fl4p/bms-c1/kicad/Parts.md

Power Switches

Cheaper: XPQR8308QB,LXHQ
NVBLS0D8N08XTXG

TODO
* do extensive search based on Rds_on/px100
* look for high Vpl switches (with eFuse)
* look for high Qgd/Qgs switches

# Todo
* build in crow-bar?
* replace power supply with lm5163
* use waveshare break-out?
* relais output
* GPIO 1A-3A switch outputs
