fl4p/bms-c1/kicad/bms-c1.kicad_pcb

## KiCad design kicad/bms-c1.kicad_pcb (2024-11-30)

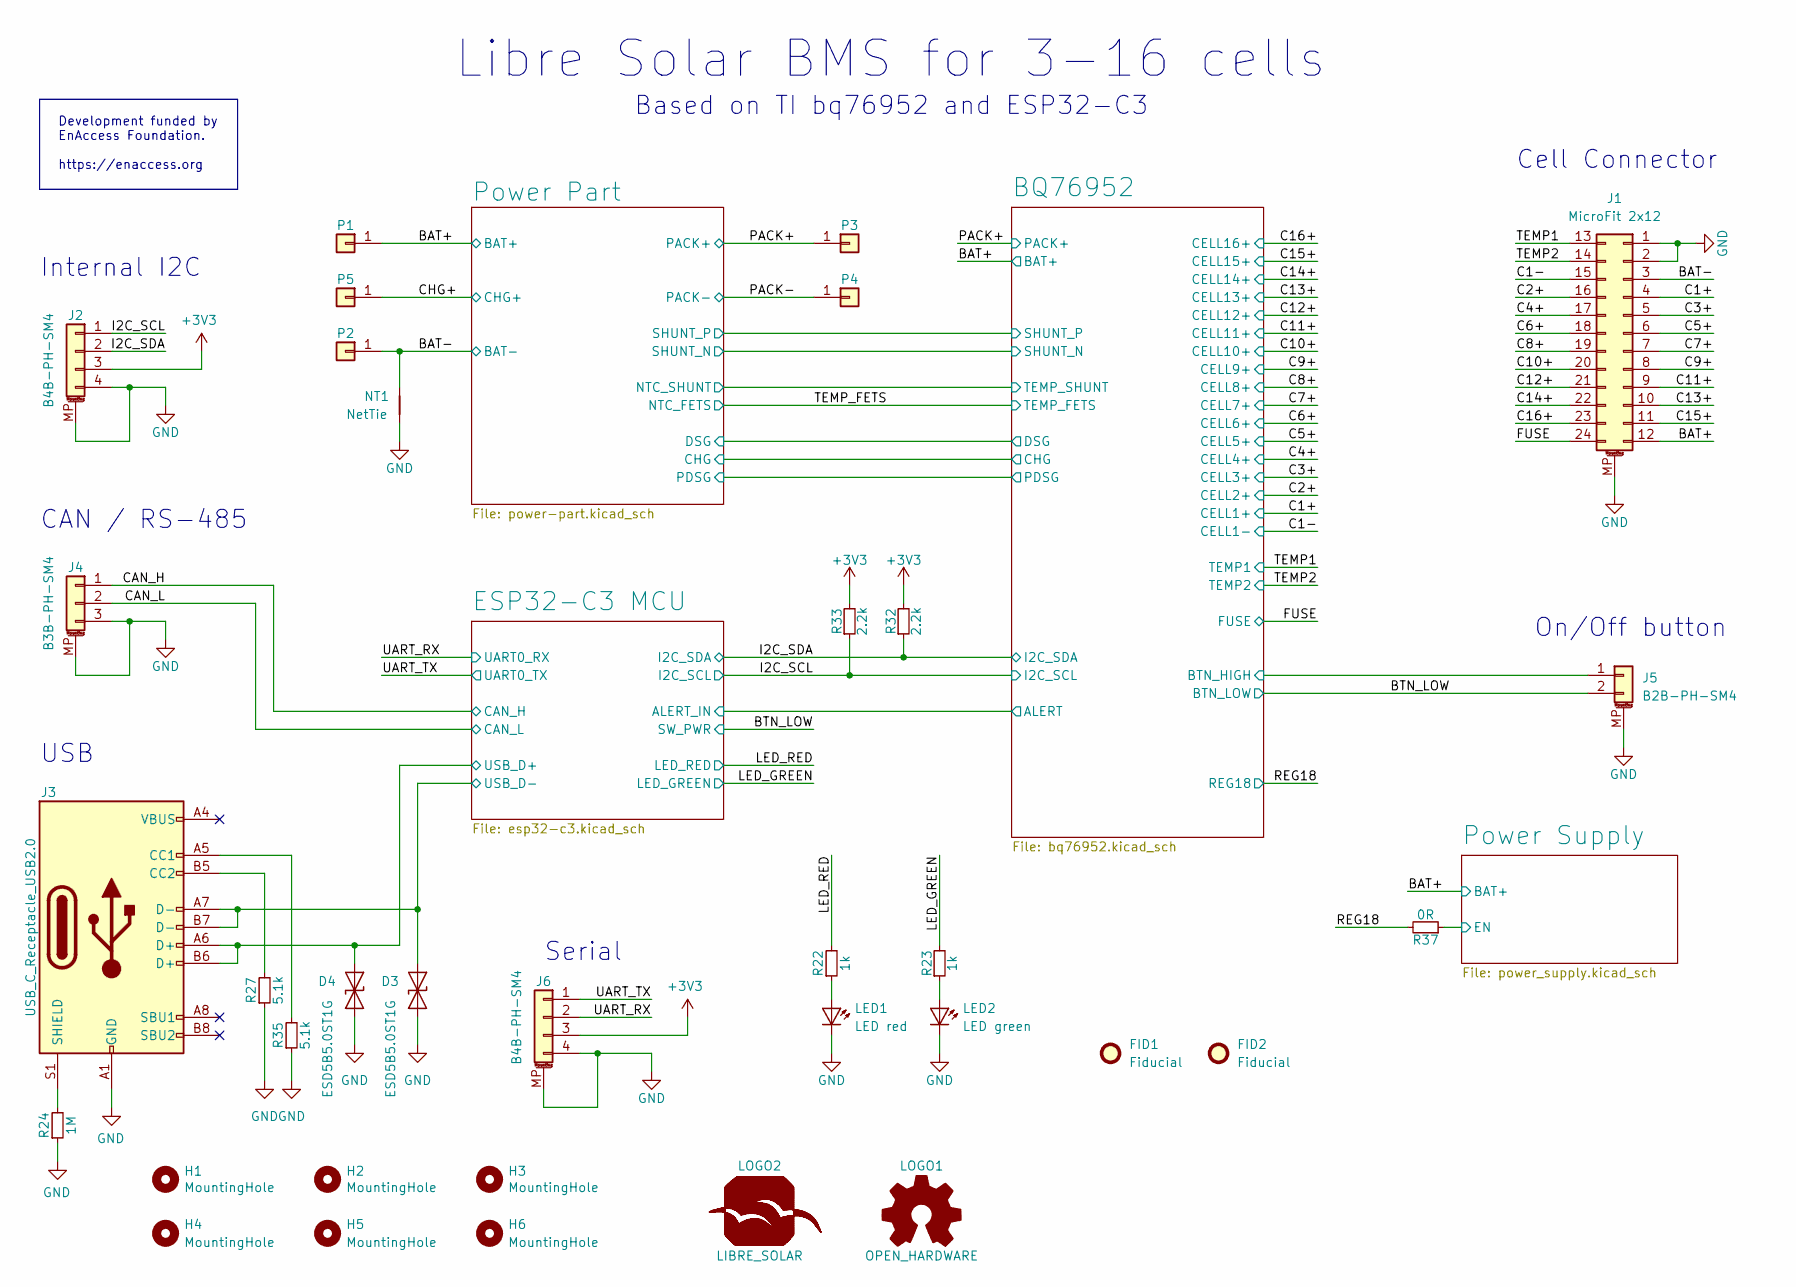
[picture p1: schematic bms-c1.kicad_sch, Libre Solar BMS C1]

Parts:
D3, D4: ESD5B5.0ST1G; D_SOD-523; PartNumber ESD5B5.0ST1G; LCSC C93623
FID1, FID2: Fiducial; Fiducial_1mm_Mask2mm
H1, H2, H3, H4, H5, H6: MountingHole; MountingHole_3.2mm_M3_Pad_TopBottom
J1: MicroFit 2x12; Molex_Micro-Fit_3.0_43045-2410_2x12-1MP_P3.00mm_Horizontal; PartNumber 662024231722
J2, J6: B4B-PH-SM4; JST_PH_B4B-PH-SM4-TB_1x04-1MP_P2.00mm_Vertical; PartNumber B4B-PH-SM4-TB(LF)(SN); LCSC C160354
J3: USB_C_Receptacle_USB2.0; USB_C_Receptacle_GCT_USB4105-xx-A_16P_TopMnt_Horizontal; PartNumber USB4105-GF-A
J4: B3B-PH-SM4; JST_PH_B3B-PH-SM4-TB_1x03-1MP_P2.00mm_Vertical; PartNumber B3B-PH-SM4-TB(LF)(SN); LCSC C160353
J5: B2B-PH-SM4; JST_PH_B2B-PH-SM4-TB_1x02-1MP_P2.00mm_Vertical; PartNumber B2B-PH-SM4-TB(LF)(SN); LCSC C160352
LED1: LED red; LED_0603_1608Metric; PartNumber LTST-C190KRKT; LCSC C94869
LED2: LED green; LED_0603_1608Metric; PartNumber LTST-C190KGKT; LCSC C125094
LOGO1: OPEN_HARDWARE; OSHW-Logo_5.7x6mm_SilkScreen
LOGO2: LIBRE_SOLAR; LIBRESOLAR_LOGO
NT1: NetTie; NetTie-2_SMD_Pad0.5mm
P1, P2, P3, P4: CONN_01X01; Wuerth_PowerPlus_M5_Nut; PartNumber 225852-E; LCSC C3217898
P5: CONN_01X01; SolderWirePad_1x01_SMD_5x10mm
R22, R23: 1k; R_0603_1608; PartNumber RC0603FR-071KL
R24: 1M; R_0603_1608; PartNumber RC0603FR-071ML
R27, R35: 5.1k; R_0603_1608; PartNumber RC0603FR-075K1L
R32, R33: 2.2k; R_0603_1608; PartNumber RC0603FR-072K2L
R37: 0R; R_0603_1608; PartNumber RC0603FR-070RL

Connections:
+3V3: J2.3, J6.3, R32.2, R33.2; also elsewhere on the board
/BAT+: J1.12, P1.1; also elsewhere on the board
/BAT-: J1.3, NT1.1, P2.1; also elsewhere on the board
/BQ76952/BTN_HIGH: J5.1; also elsewhere on the board
/BTN_LOW: J5.2; also elsewhere on the board
/C1+: J1.4; also elsewhere on the board
/C1-: J1.15; also elsewhere on the board
/C2+: J1.16; also elsewhere on the board
/C3+: J1.5; also elsewhere on the board
/C4+: J1.17; also elsewhere on the board
/C5+: J1.6; also elsewhere on the board
/C6+: J1.18; also elsewhere on the board
/C7+: J1.7; also elsewhere on the board
/C8+: J1.19; also elsewhere on the board
/C9+: J1.8; also elsewhere on the board
/C10+: J1.20; also elsewhere on the board
/C11+: J1.9; also elsewhere on the board
/C12+: J1.21; also elsewhere on the board
/C13+: J1.10; also elsewhere on the board
/C14+: J1.22; also elsewhere on the board
/C15+: J1.11; also elsewhere on the board
/C16+: J1.23; also elsewhere on the board
/CAN_H: J4.1; also elsewhere on the board
/CAN_L: J4.2; also elsewhere on the board
/CHG+: P5.1; also elsewhere on the board
/ESP32-C3 MCU/USB_D+: D4.2 (A2), J3.A6 (D+), J3.B6 (D+); also elsewhere on the board
/ESP32-C3 MCU/USB_D-: D3.2 (A2), J3.A7 (D-), J3.B7 (D-); also elsewhere on the board
/FUSE: J1.24; also elsewhere on the board
/I2C_SCL: J2.1, R33.1; also elsewhere on the board
/I2C_SDA: J2.2, R32.1; also elsewhere on the board
/LED_GREEN: R23.2; also elsewhere on the board
/LED_RED: R22.2; also elsewhere on the board
/PACK+: P3.1; also elsewhere on the board
/PACK-: P4.1; also elsewhere on the board
/Power Supply/EN: R37.1; also elsewhere on the board
/REG18: R37.2; also elsewhere on the board
/TEMP1: J1.13; also elsewhere on the board
/TEMP2: J1.14; also elsewhere on the board
/UART_RX: J6.2; also elsewhere on the board
/UART_TX: J6.1; also elsewhere on the board
GND: D3.1 (A1), D4.1 (A1), J1.1, J1.2, J1.MP (MountPin), J2.4, J2.MP (MountPin), J3.A1 (GND), J3.A12 (GND), J3.B1 (GND), J3.B12 (GND), J4.3, J4.MP (MountPin), J5.MP (MountPin), J6.4, J6.MP (MountPin), LED1.1 (K), LED2.1 (K), NT1.2, R24.1, R27.1, R35.1; also elsewhere on the board
unnamed: J3.A5 (CC1), R35.2
unnamed: J3.B5 (CC2), R27.2
unnamed: J3.S1 (SHIELD), R24.2
unnamed: LED1.2 (A), R22.1
unnamed: LED2.2 (A), R23.1

Notes on the sheet:
Based on TI bq76952 and ESP32-C3
CAN / RS-485
Development funded by EnAccess Foundation. https://enaccess.org
USB
Serial
Libre Solar BMS for 3-16 cells
Cell Connector
Internal I2C
On/Off button

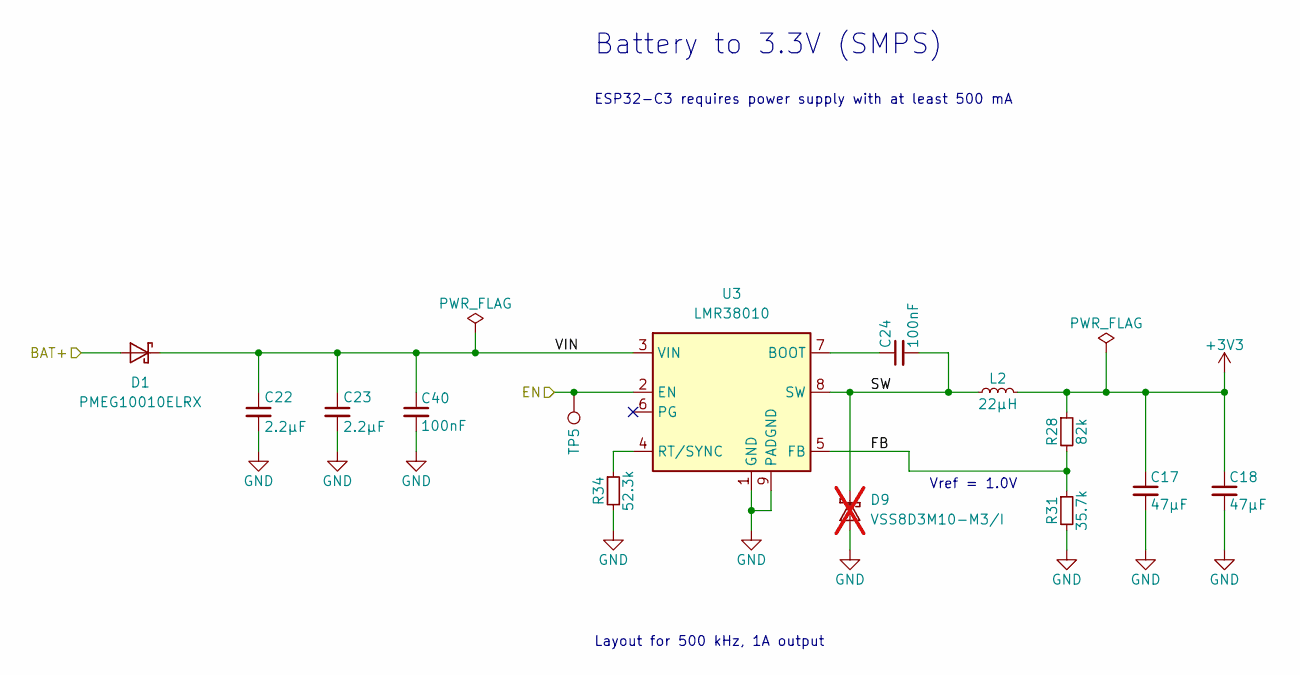
[picture p2: schematic power_supply.kicad_sch, Libre Solar BMS C1]

Parts:
C17, C18: 47µF; C_1210_3225; PartNumber CL32B476MPJNNNE; LCSC C525654
C22, C23: 2.2µF; C_1210_3225; PartNumber CL32B225KCJSNNE; LCSC C55151
C24, C40: 100nF; C_0603_1608; PartNumber CL10B104KC8NNNC; LCSC C15725
D1: PMEG10010ELRX; D_SOD-123F; PartNumber PMEG10010ELRX; LCSC C179426
D9: VSS8D3M10-M3/I; D_SOD-128; PartNumber VSS8D3M10-M3/H; LCSC C3760174; not fitted
L2: 22µH; Bourns_SRN8040TA; PartNumber SRN8040-220M; LCSC C92946
R28: 82k; R_0603_1608; PartNumber RC0603FR-0782KL
R31: 35.7k; R_0603_1608; PartNumber RC0603FR-0735K7L
R34: 52.3k; R_0603_1608; PartNumber RC0603FR-0752K3L
TP5: TestPoint; TestPoint_Pad_D1.5mm
U3: LMR38010; SOIC-8-1EP_3.9x4.9mm_P1.27mm_EP2.4x3.1mm_ThermalVias; PartNumber LMR38010SDDAR; LCSC C3192337

Connections:
+3V3: C17.1, C18.1, L2.2, R28.1; also elsewhere on the board
/BAT+: D1.2 (A); also elsewhere on the board
/Power Supply/EN: TP5.1, U3.2 (EN); also elsewhere on the board
/Power Supply/FB: R28.2, R31.1, U3.5 (FB)
/Power Supply/SW: C24.2, D9.1 (K), L2.1, U3.8 (SW)
/Power Supply/VIN: C22.1, C23.1, C40.1, D1.1 (K), U3.3 (VIN)
GND: C17.2, C18.2, C22.2, C23.2, C40.2, D9.2 (A), R31.2, R34.2, U3.1 (GND), U3.9 (PADGND); also elsewhere on the board
unnamed: C24.1, U3.7 (BOOT)
unnamed: R34.1, U3.4 (RT/SYNC)

Notes on the sheet:
ESP32-C3 requires power supply with at least 500 mA
Layout for 500 kHz, 1A output
Battery to 3.3V (SMPS)
Vref = 1.0V

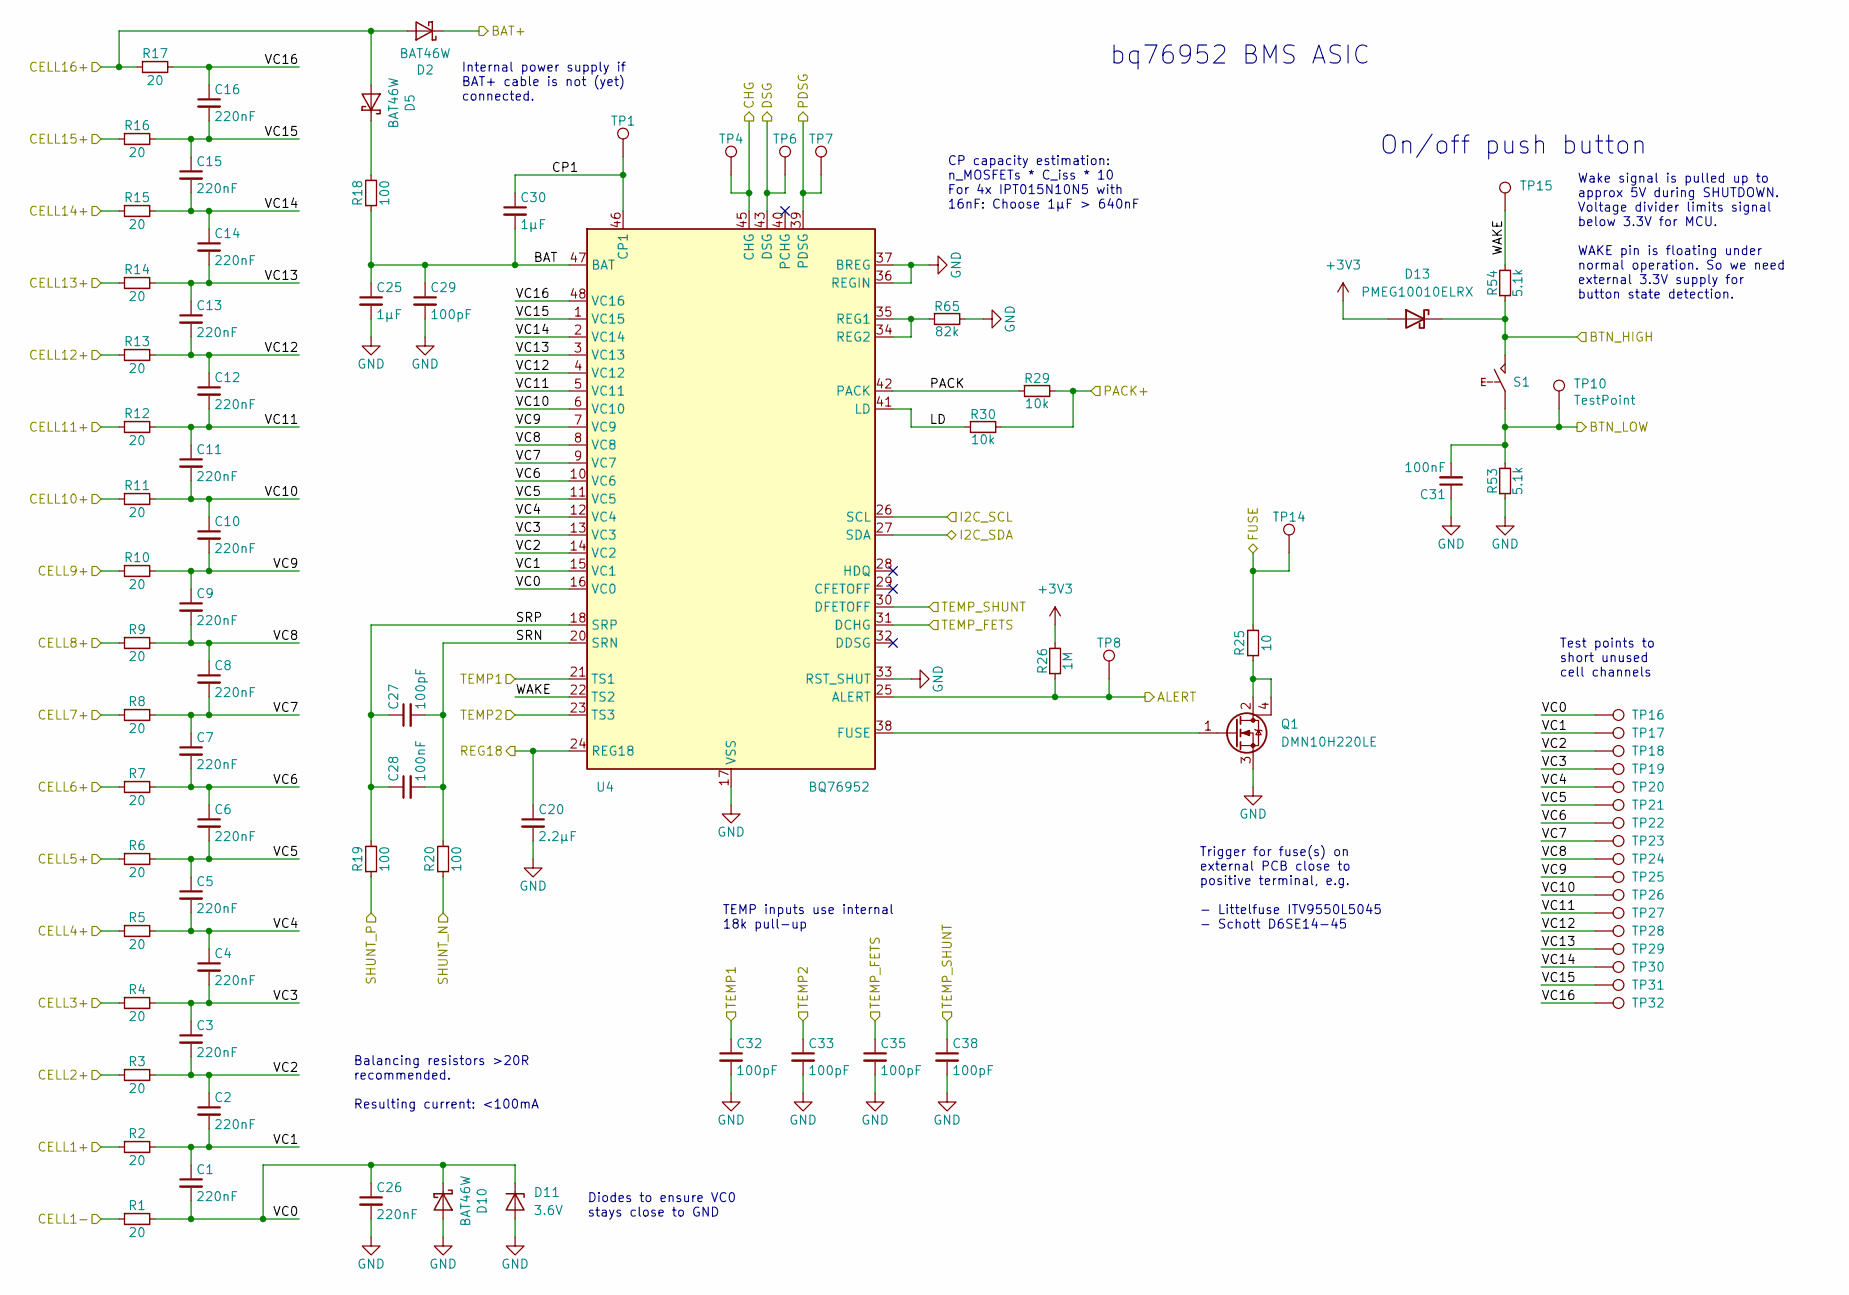
[picture p3: schematic bq76952.kicad_sch, Libre Solar BMS C1]

Parts:
C1, C2, C3, C4, C5, C6, C7, C8, C9, C10, C11, C12, C13, C14, C15, C16, C26: 220nF; C_0603_1608; PartNumber CL10B224KA8NNNC; LCSC C21120
C20: 2.2µF; C_0603_1608; PartNumber CL10A225KP8NNNC; LCSC C1607
C25: 1µF; C_1206_3216; PartNumber CL31B105KCHNNNE; LCSC C13832
C27, C29, C32, C33, C35, C38: 100pF; C_0603_1608; PartNumber CL10C101JC8NNNC; LCSC C296717
C28, C31: 100nF; C_0603_1608; PartNumber CL10B104KC8NNNC; LCSC C15725
C30: 1µF; C_0603_1608; PartNumber CL10A105KA8NNNC; LCSC C5673
D2, D5, D10: BAT46W; D_SOD-123; PartNumber BAT46W-7-F; LCSC C83152
D11: 3.6V; D_SOD-123; PartNumber MMSZ4685T1G; LCSC C66886
D13: PMEG10010ELRX; D_SOD-123F; PartNumber PMEG10010ELRX; LCSC C179426
Q1: DMN10H220LE; SOT-223; PartNumber DMN10H220LE; LCSC C258216
R1, R2, R3, R4, R5, R6, R7, R8, R9, R10, R11, R12, R13, R14, R15, R16, R17: 20; R_2010_5025; PartNumber RC2010JK-0720RL; LCSC C163344
R18: 100; R_1206_3216; PartNumber RC1206FR-07100RL
R19, R20: 100; R_0603_1608; PartNumber RC0603FR-07100RL
R25: 10; R_1206_3216; PartNumber RC1206FR-0710RL
R26: 1M; R_0603_1608; PartNumber RC0603FR-071ML
R29, R30: 10k; R_0603_1608; PartNumber RC0603FR-0710KL
R53, R54: 5.1k; R_0603_1608; PartNumber RC0603FR-075K1L
R65: 82k; R_0603_1608; PartNumber RC0603FR-0782KL
S1: SW_PUSH; SW_SPST_TL3305A; PartNumber TL3305AF160QG; LCSC C2886899
TP1, TP4, TP6, TP7, TP8, TP10, TP14, TP15: TestPoint; TestPoint_Pad_D1.5mm
TP16, TP17, TP18, TP19, TP20, TP21, TP22, TP23, TP24, TP25, TP26, TP27, TP28, TP29, TP30, TP31, TP32: TestPoint; TestPoint_Pad_1.0x1.0mm
U4: BQ76952; TQFP-48_7x7mm_P0.5mm; PartNumber BQ76952PFBR; LCSC C2862742

Connections:
+3V3: D13.2 (A), R26.2; also elsewhere on the board
/BAT+: D2.1 (K); also elsewhere on the board
/BQ76952/ALERT: R26.1, TP8.1, U4.25 (ALERT); also elsewhere on the board
/BQ76952/BAT: C25.1, C29.1, C30.2, R18.1, U4.47 (BAT)
/BQ76952/BTN_HIGH: D13.1 (K), R54.1, S1.2; also elsewhere on the board
/BQ76952/CHG: TP4.1, U4.45 (CHG); also elsewhere on the board
/BQ76952/CP1: C30.1, TP1.1, U4.46 (CP1)
/BQ76952/DSG: TP6.1, U4.43 (DSG); also elsewhere on the board
/BQ76952/LD: R30.1, U4.41 (LD)
/BQ76952/PACK: R29.1, U4.42 (PACK)
/BQ76952/PDSG: TP7.1, U4.39 (PDSG); also elsewhere on the board
/BQ76952/SHUNT_N: R20.1; also elsewhere on the board
/BQ76952/SHUNT_P: R19.1; also elsewhere on the board
/BQ76952/SRN: C27.2, C28.2, R20.2, U4.20 (SRN)
/BQ76952/SRP: C27.1, C28.1, R19.2, U4.18 (SRP)
/BQ76952/TEMP_SHUNT: C38.1, U4.30 (DFETOFF); also elsewhere on the board
/BQ76952/VC0: C1.2, C26.1, D10.1 (K), D11.1 (K), R1.2, TP16.1, U4.16 (VC0)
/BQ76952/VC1: C1.1, C2.2, R2.2, TP17.1, U4.15 (VC1)
/BQ76952/VC2: C2.1, C3.2, R3.2, TP18.1, U4.14 (VC2)
/BQ76952/VC3: C3.1, C4.2, R4.2, TP19.1, U4.13 (VC3)
/BQ76952/VC4: C4.1, C5.2, R5.2, TP20.1, U4.12 (VC4)
/BQ76952/VC5: C5.1, C6.2, R6.2, TP21.1, U4.11 (VC5)
/BQ76952/VC6: C6.1, C7.2, R7.2, TP22.1, U4.10 (VC6)
/BQ76952/VC7: C7.1, C8.2, R8.2, TP23.1, U4.9 (VC7)
/BQ76952/VC8: C8.1, C9.2, R9.2, TP24.1, U4.8 (VC8)
/BQ76952/VC9: C9.1, C10.2, R10.2, TP25.1, U4.7 (VC9)
/BQ76952/VC10: C10.1, C11.2, R11.2, TP26.1, U4.6 (VC10)
/BQ76952/VC11: C11.1, C12.2, R12.2, TP27.1, U4.5 (VC11)
/BQ76952/VC12: C12.1, C13.2, R13.2, TP28.1, U4.4 (VC12)
/BQ76952/VC13: C13.1, C14.2, R14.2, TP29.1, U4.3 (VC13)
/BQ76952/VC14: C14.1, C15.2, R15.2, TP30.1, U4.2 (VC14)
/BQ76952/VC15: C15.1, C16.2, R16.2, TP31.1, U4.1 (VC15)
/BQ76952/VC16: C16.1, R17.2, TP32.1, U4.48 (VC16)
/BQ76952/WAKE: R54.2, TP15.1, U4.22 (TS2)
/BTN_LOW: C31.2, R53.2, S1.1, TP10.1; also elsewhere on the board
/C1+: R2.1; also elsewhere on the board
/C1-: R1.1; also elsewhere on the board
/C2+: R3.1; also elsewhere on the board
/C3+: R4.1; also elsewhere on the board
/C4+: R5.1; also elsewhere on the board
/C5+: R6.1; also elsewhere on the board
/C6+: R7.1; also elsewhere on the board
/C7+: R8.1; also elsewhere on the board
/C8+: R9.1; also elsewhere on the board
/C9+: R10.1; also elsewhere on the board
/C10+: R11.1; also elsewhere on the board
/C11+: R12.1; also elsewhere on the board
/C12+: R13.1; also elsewhere on the board
/C13+: R14.1; also elsewhere on the board
/C14+: R15.1; also elsewhere on the board
/C15+: R16.1; also elsewhere on the board
/C16+: D2.2 (A), D5.2 (A), R17.1; also elsewhere on the board
/FUSE: R25.2, TP14.1; also elsewhere on the board
/I2C_SCL: U4.26 (SCL); also elsewhere on the board
/I2C_SDA: U4.27 (SDA); also elsewhere on the board
/PACK+: R29.2, R30.2; also elsewhere on the board
/REG18: C20.1, U4.24 (REG18); also elsewhere on the board
/TEMP1: C32.1, U4.21 (TS1); also elsewhere on the board
/TEMP2: C33.1, U4.23 (TS3); also elsewhere on the board
/TEMP_FETS: C35.1, U4.31 (DCHG); also elsewhere on the board
GND: C20.2, C25.2, C26.2, C29.2, C31.1, C32.2, C33.2, C35.2, C38.2, D10.2 (A), D11.2 (A), Q1.3 (S), R53.1, R65.2, U4.17 (VSS), U4.33 (RST_SHUT), U4.36 (REGIN), U4.37 (BREG); also elsewhere on the board
unnamed: D5.1 (K), R18.2
unnamed: Q1.2 (D), Q1.4 (D), R25.1
unnamed: Q1.1 (G), U4.38 (FUSE)
unnamed: R65.1, U4.34 (REG2), U4.35 (REG1)

Notes on the sheet:
TEMP inputs use internal 18k pull-up
CP capacity estimation: n_MOSFETs * C_iss * 10 For 4x IPT015N10N5 with 16nF: Choose 1µF > 640nF
bq76952 BMS ASIC
Wake signal is pulled up to approx 5V during SHUTDOWN. Voltage divider limits signal below 3.3V for MCU. WAKE pin is floating under normal operation. So we need external 3.3V supply for button state detection.
On/off push button
Trigger for fuse(s) on external PCB close to positive terminal, e.g. - Littelfuse ITV9550L5045 - Schott D6SE14-45
Balancing resistors >20R recommended. Resulting current: <100mA
Test points to short unused cell channels
Internal power supply if BAT+ cable is not (yet) connected.
Diodes to ensure VC0 stays close to GND

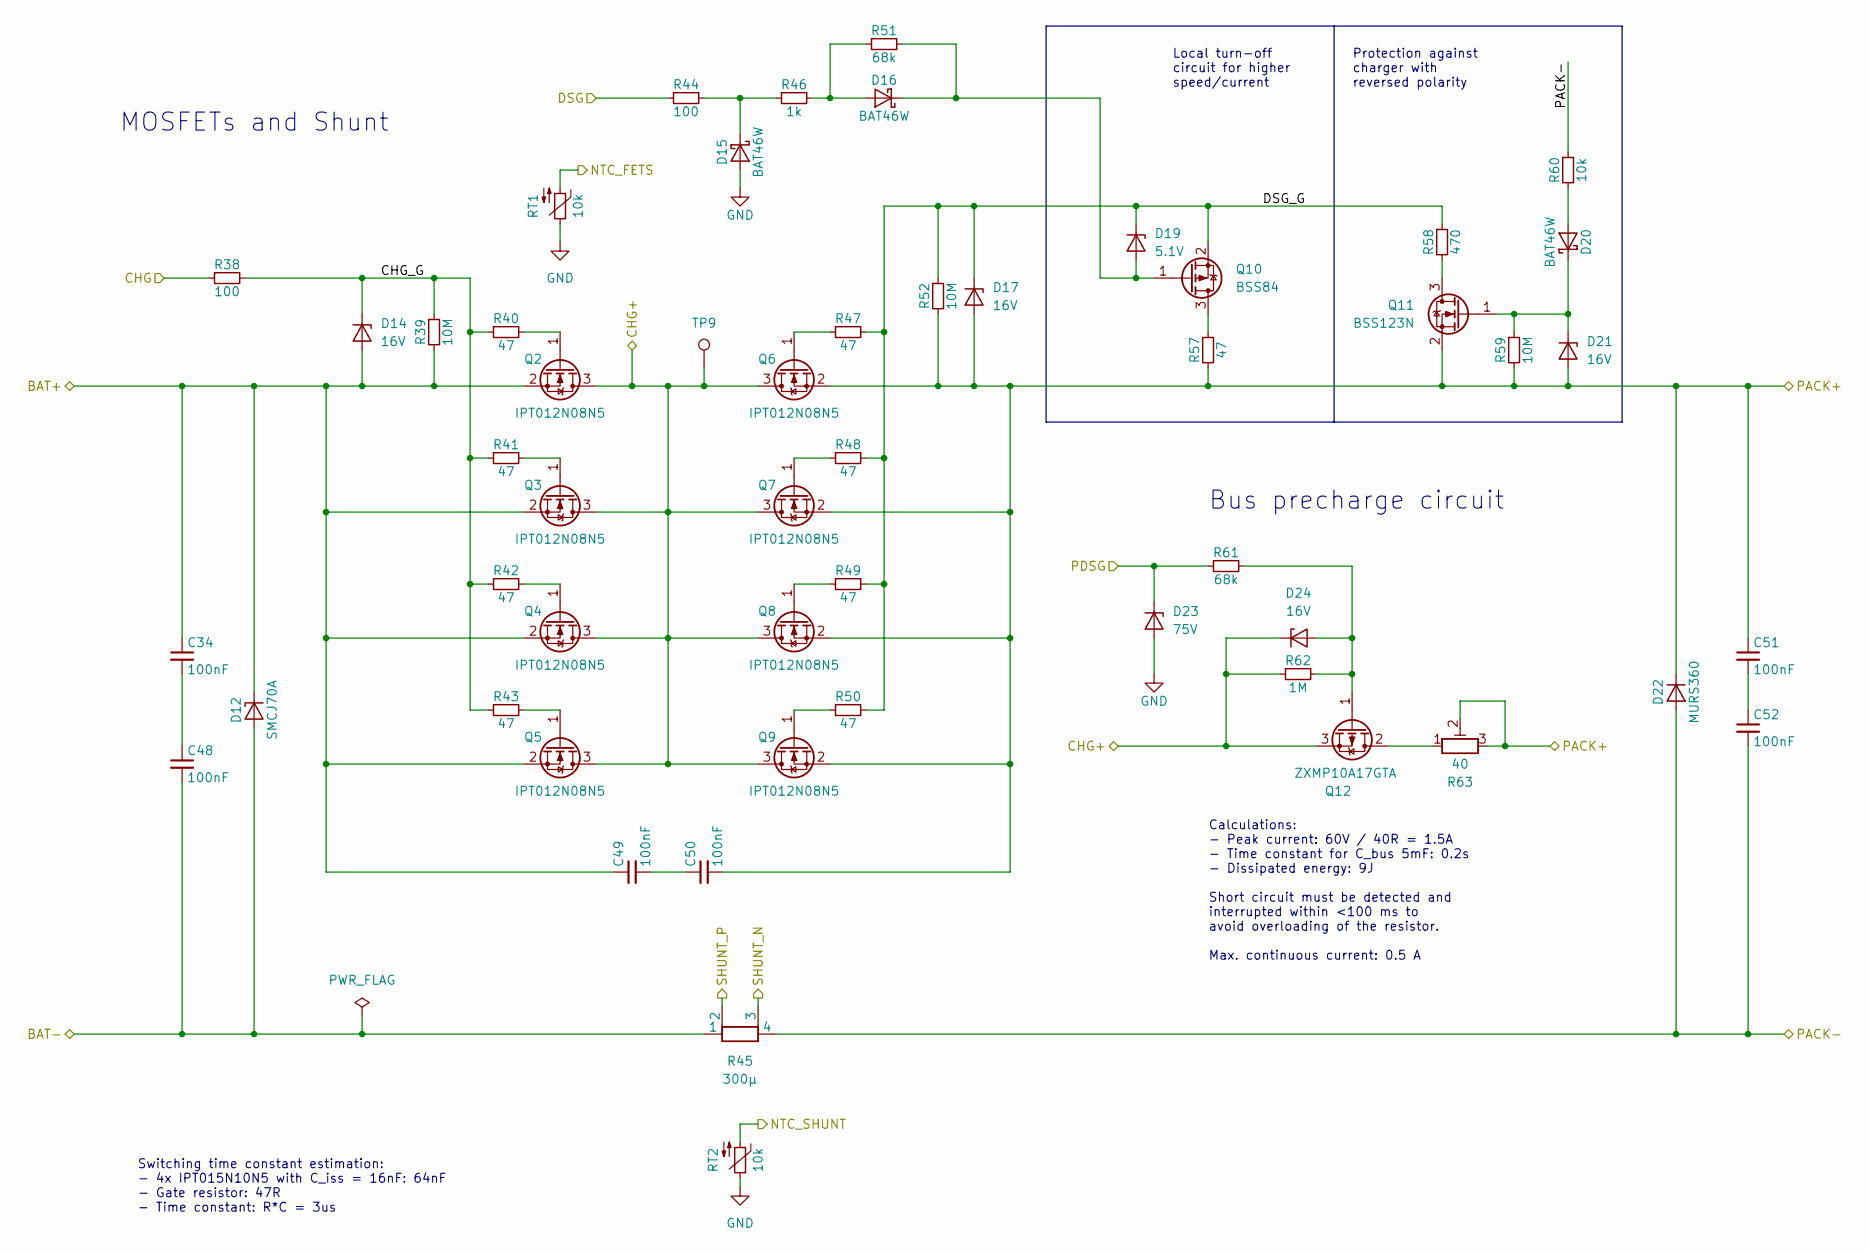
[picture p4: schematic power-part.kicad_sch, Libre Solar BMS C1]

Parts:
C34, C48, C49, C50, C51, C52: 100nF; C_0603_1608; PartNumber CL10B104KC8NNNC; LCSC C15725
D12: SMCJ70A; D_SMC; PartNumber SMCJ70A; LCSC C135194
D14, D17, D21, D24: 16V; D_SOD-123; PartNumber MMSZ5246B-7-F; LCSC C282317
D15, D16, D20: BAT46W; D_SOD-123; PartNumber BAT46W-7-F; LCSC C83152
D19: 5.1V; D_SOD-323; PartNumber BZT52C5V1S-7-F; LCSC C151348
D22: MURS360; D_SMC; PartNumber MURS360; LCSC C388245
D23: 75V; D_SOD-123; PartNumber MMSZ5267BT1G; LCSC C266795
Q2, Q3, Q4, Q5, Q6, Q7, Q8, Q9: IPT012N08N5; Infineon_PG-HSOF-8-1_ThermalVias; PartNumber IPT012N08N5; LCSC C531199
Q10: BSS84; SOT-23; PartNumber BSS84AK,215; LCSC C127273
Q11: BSS123N; SOT-23; PartNumber BSS123N H6327; LCSC C534594
Q12: ZXMP10A17GTA; SOT-223-3_TabPin2; PartNumber ZXMP10A17GTA; LCSC C32998
R38, R44: 100; R_0603_1608; PartNumber RC0603FR-07100RL
R39, R52, R59: 10M; R_0603_1608; PartNumber RC0603FR-0710ML
R40, R41, R42, R43, R47, R48, R49, R50, R57: 47; R_0603_1608; PartNumber RC0603FR-0747RL
R45: 300µ; R_Shunt_5931_Kelvin; PartNumber WSLP5931L3000FEA
R46: 1k; R_0603_1608; PartNumber RC0603FR-071KL
R51, R61: 68k; R_0603_1608; PartNumber RC0603FR-0768KL
R58: 470; R_0603_1608; PartNumber RC0603FR-07470RL
R60: 10k; R_0603_1608; PartNumber RC0603FR-0710KL
R62: 1M; R_0603_1608; PartNumber RC0603FR-071ML
R63: 40; Bourns_PWR163; PartNumber PWR163S-25-40R0FE
RT1, RT2: 10k; R_0603_1608; PartNumber NTCG163JF103FT1S; LCSC C406719
TP9: TestPoint; TestPoint_Pad_D1.5mm

Connections:
/BAT+: C34.1, C49.1, D12.1 (K), D14.2 (A), Q2.2 (S), Q3.2 (S), Q4.2 (S), Q5.2 (S), R39.2; also elsewhere on the board
/BAT-: C48.2, D12.2 (A), R45.1; also elsewhere on the board
/BQ76952/CHG: R38.1; also elsewhere on the board
/BQ76952/DSG: R44.1; also elsewhere on the board
/BQ76952/PDSG: D23.1 (K), R61.1; also elsewhere on the board
/BQ76952/SHUNT_N: R45.3; also elsewhere on the board
/BQ76952/SHUNT_P: R45.2; also elsewhere on the board
/BQ76952/TEMP_SHUNT: RT2.2; also elsewhere on the board
/CHG+: D24.1 (K), Q2.3 (D), Q3.3 (D), Q4.3 (D), Q5.3 (D), Q6.3 (D), Q7.3 (D), Q8.3 (D), Q9.3 (D), Q12.3 (S), R62.1, TP9.1; also elsewhere on the board
/PACK+: C50.2, C51.1, D17.2 (A), D21.2 (A), D22.1 (K), Q6.2 (S), Q7.2 (S), Q8.2 (S), Q9.2 (S), Q11.2 (S), R52.2, R57.1, R59.2, R63.2, R63.3; also elsewhere on the board
/PACK-: C52.2, D22.2 (A), R45.4, R60.1; also elsewhere on the board
/Power Part/CHG_G: D14.1 (K), R38.2, R39.1, R40.1, R41.1, R42.1, R43.1
/Power Part/DSG_G: D17.1 (K), D19.1 (K), Q10.2 (S), R47.2, R48.2, R49.2, R50.2, R52.1, R58.1
/TEMP_FETS: RT1.2; also elsewhere on the board
GND: D15.2 (A), D23.2 (A), RT1.1, RT2.1; also elsewhere on the board
unnamed: C34.2, C48.1
unnamed: C49.2, C50.1
unnamed: C51.2, C52.1
unnamed: D15.1 (K), R44.2, R46.1
unnamed: D16.2 (A), R46.2, R51.1
unnamed: D16.1 (K), D19.2 (A), Q10.1 (G), R51.2
unnamed: D20.2 (A), R60.2
unnamed: D20.1 (K), D21.1 (K), Q11.1 (G), R59.1
unnamed: D24.2 (A), Q12.1 (G), R61.2, R62.2
unnamed: Q2.1 (G), R40.2
unnamed: Q3.1 (G), R41.2
unnamed: Q4.1 (G), R42.2
unnamed: Q5.1 (G), R43.2
unnamed: Q6.1 (G), R47.1
unnamed: Q7.1 (G), R48.1
unnamed: Q8.1 (G), R49.1
unnamed: Q9.1 (G), R50.1
unnamed: Q10.3 (D), R57.2
unnamed: Q11.3 (D), R58.2
unnamed: Q12.2 (D), R63.1

Notes on the sheet:
Protection against charger with reversed polarity
Switching time constant estimation: - 4x IPT015N10N5 with C_iss = 16nF: 64nF - Gate resistor: 47R - Time constant: R*C = 3us
MOSFETs and Shunt
Local turn-off circuit for higher speed/current
Bus precharge circuit
Calculations: - Peak current: 60V / 40R = 1.5A - Time constant for C_bus 5mF: 0.2s - Dissipated energy: 9J Short circuit must be detected and interrupted within <100 ms to avoid overloading of the resistor. Max. continuous current: 0.5 A

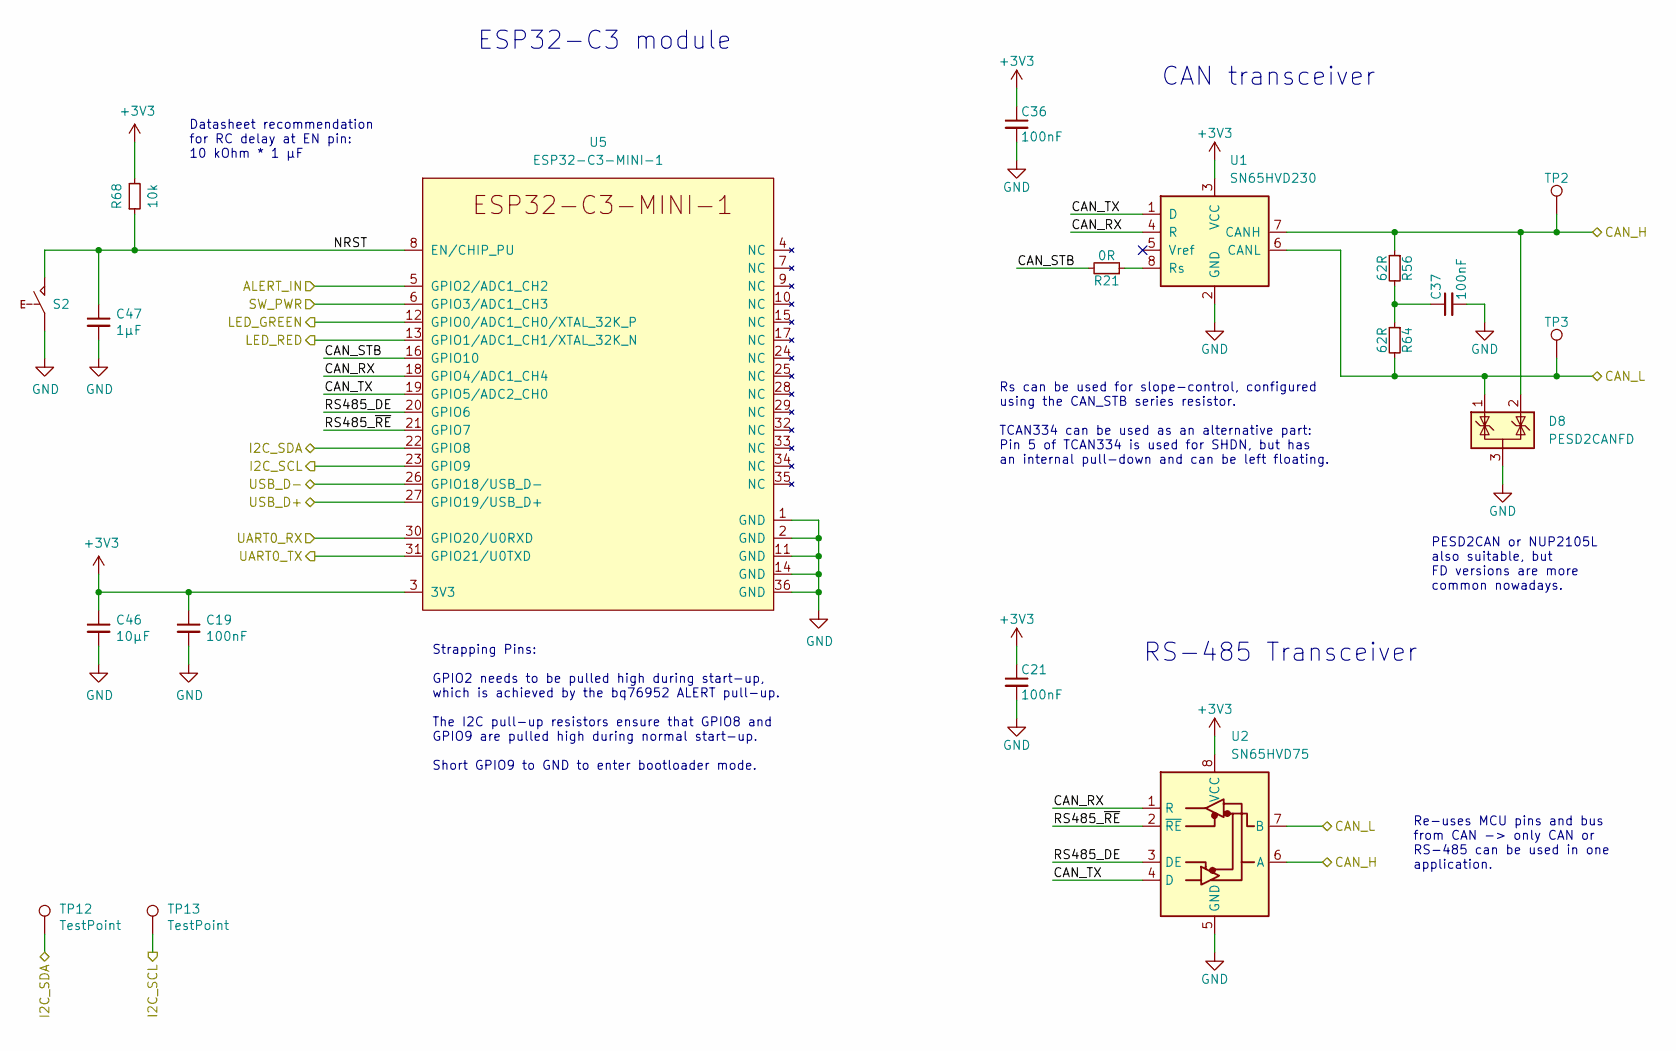
[picture p5: schematic esp32-c3.kicad_sch, Libre Solar BMS C1]

Parts:
C19, C21, C36, C37: 100nF; C_0603_1608; PartNumber CL10B104KC8NNNC; LCSC C15725
C46: 10µF; C_0805_2012; PartNumber CL21A106KPFNNNE; LCSC C17024
C47: 1µF; C_0603_1608; PartNumber CL10A105KA8NNNC; LCSC C5673
D8: PESD2CANFD; SOT-23; PartNumber PESD2CANFD24V-TR; LCSC C552486
R21: 0R; R_0603_1608; PartNumber RC0603FR-070RL
R56, R64: 62R; R_0603_1608; PartNumber RC0603FR-0762RL
R68: 10k; R_0603_1608; PartNumber RC0603FR-0710KL
S2: SW_PUSH; SW_SPST_TL3305A; PartNumber TL3305AF160QG; LCSC C2886899
TP2, TP3, TP12, TP13: TestPoint; TestPoint_Pad_D1.5mm
U1: SN65HVD230; SOIC-8_3.9x4.9mm_P1.27mm; PartNumber SN65HVD230DR; LCSC C12084
U2: SN65HVD75; SOIC-8_3.9x4.9mm_P1.27mm; PartNumber SN65HVD75DR; LCSC C57928
U5: ESP32-C3-MINI-1; PartNumber ESP32-C3-MINI-1-N4; LCSC C2838502

Connections:
+3V3: C19.1, C21.1, C36.1, C46.1, R68.2, U1.3 (VCC), U2.8 (VCC), U5.3 (3V3); also elsewhere on the board
/BQ76952/ALERT: U5.5 (GPIO2/ADC1_CH2); also elsewhere on the board
/BTN_LOW: U5.6 (GPIO3/ADC1_CH3); also elsewhere on the board
/CAN_H: D8.2 (K), R56.1, TP2.1, U1.7 (CANH), U2.6 (A); also elsewhere on the board
/CAN_L: D8.1 (K), R64.2, TP3.1, U1.6 (CANL), U2.7 (B); also elsewhere on the board
/ESP32-C3 MCU/CAN_RX: U1.4 (R), U2.1 (R), U5.18 (GPIO4/ADC1_CH4)
/ESP32-C3 MCU/CAN_STB: R21.2, U5.16 (GPIO10)
/ESP32-C3 MCU/CAN_TX: U1.1 (D), U2.4 (D), U5.19 (GPIO5/ADC2_CH0)
/ESP32-C3 MCU/NRST: C47.1, R68.1, S2.2, U5.8 (EN/CHIP_PU)
/ESP32-C3 MCU/RS485_DE: U2.3 (DE), U5.20 (GPIO6)
/ESP32-C3 MCU/RS485_~RE: U2.2 (~RE), U5.21 (GPIO7)
/ESP32-C3 MCU/USB_D+: U5.27 (GPIO19/USB_D+); also elsewhere on the board
/ESP32-C3 MCU/USB_D-: U5.26 (GPIO18/USB_D-); also elsewhere on the board
/I2C_SCL: TP13.1, U5.23 (GPIO9); also elsewhere on the board
/I2C_SDA: TP12.1, U5.22 (GPIO8); also elsewhere on the board
/LED_GREEN: U5.12 (GPIO0/ADC1_CH0/XTAL_32K_P); also elsewhere on the board
/LED_RED: U5.13 (GPIO1/ADC1_CH1/XTAL_32K_N); also elsewhere on the board
/UART_RX: U5.30 (GPIO20/U0RXD); also elsewhere on the board
/UART_TX: U5.31 (GPIO21/U0TXD); also elsewhere on the board
GND: C19.2, C21.2, C36.2, C37.2, C46.2, C47.2, D8.3 (A), S2.1, U1.2 (GND), U2.5 (GND), U5.1 (GND), U5.2 (GND), U5.11 (GND), U5.14 (GND), U5.36 (GND); also elsewhere on the board
unnamed: C37.1, R56.2, R64.1
unnamed: R21.1, U1.8 (Rs)

Notes on the sheet:
Datasheet recommendation for RC delay at EN pin: 10 kOhm * 1 µF
Strapping Pins: GPIO2 needs to be pulled high during start-up, which is achieved by the bq76952 ALERT pull-up. The I2C pull-up resistors ensure that GPIO8 and GPIO9 are pulled high during normal start-up. Short GPIO9 to GND to enter bootloader mode.
RS-485 Transceiver
Re-uses MCU pins and bus from CAN -> only CAN or RS-485 can be used in one application.
PESD2CAN or NUP2105L also suitable, but FD versions are more common nowadays.
CAN transceiver
ESP32-C3 module
Rs can be used for slope-control, configured using the CAN_STB series resistor. TCAN334 can be used as an alternative part: Pin 5 of TCAN334 is used for SHDN, but has an internal pull-down and can be left floating.

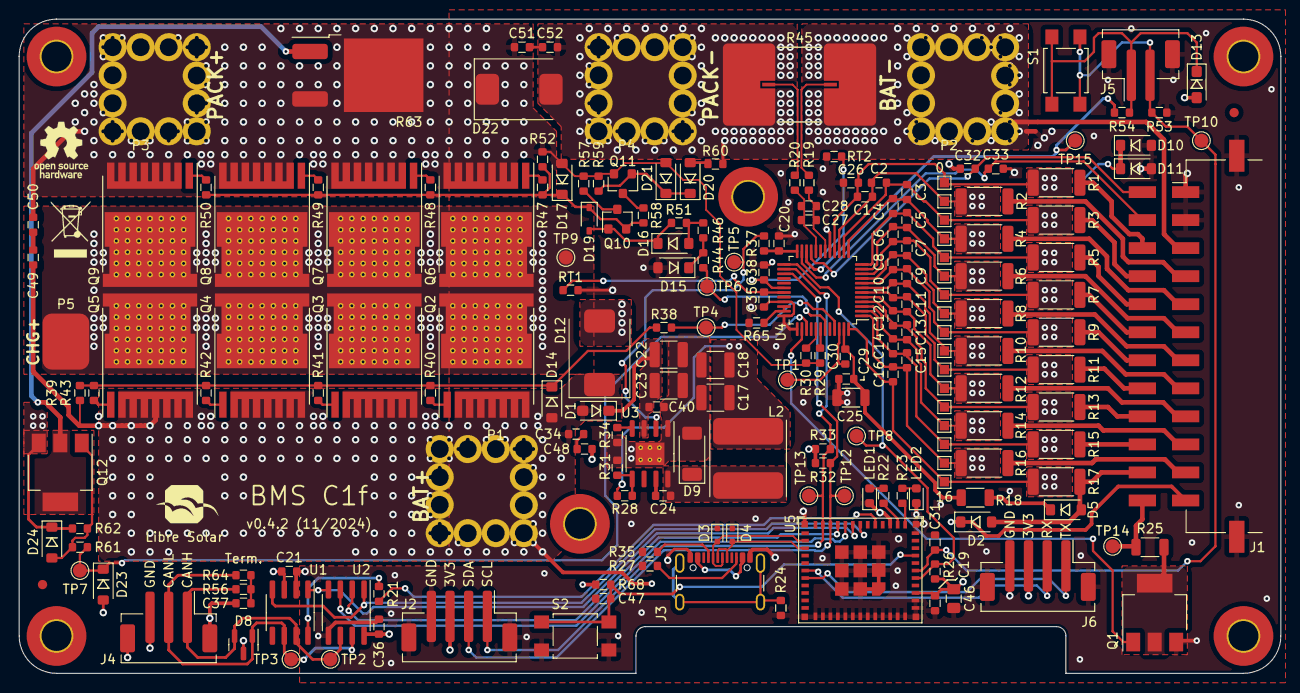
[picture p6: board bms-c1.kicad_pcb from above]

Board: 4 copper layers, 135.0 x 70.0 mm, 208 parts (0 on the bottom side), 117 nets.
