fl4p/bms-c1/(notices)

Notices in the files:
kicad/esp32-c3.kicad_sch:
License: CERN-OHL-W
